DayanaHV/Fundamentos-de-Dise-o/README.md

# Fundamentos-de-Dise-o
 Ciclo 2023-0

Integrantes:
- CHAVEZ ESPIRITU, JENNIFER ARACELY
- HERRERA VALENCIA, DAYANA ARABELA
- NAVARRO VALDIVIEZO, VICTORIA JUSTA
- PACSI INGA, SARANSH DANIELA MILAGROS
- VALLE ROMERO, BRITNEY INES
