DayanaHV/Fundamentos-de-Dise-o/Hardware/Proyectos preliminares_Gran escala/Proyecto preliminar 1.pdf

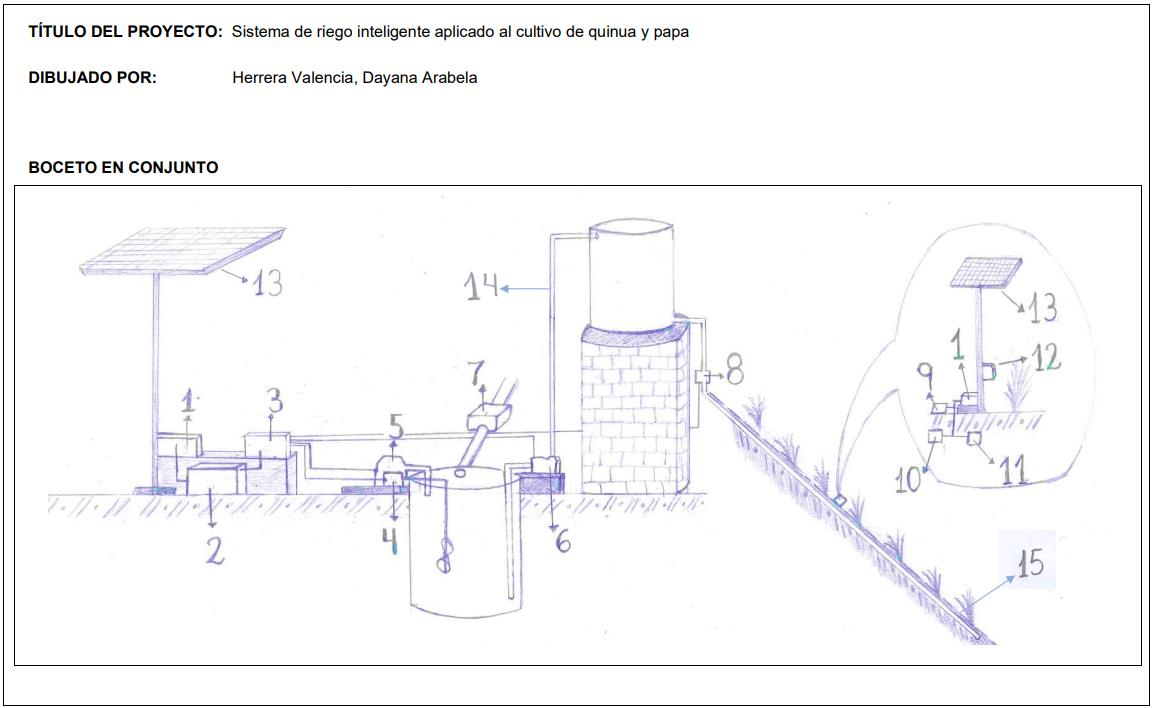
[picture p1: page 1]
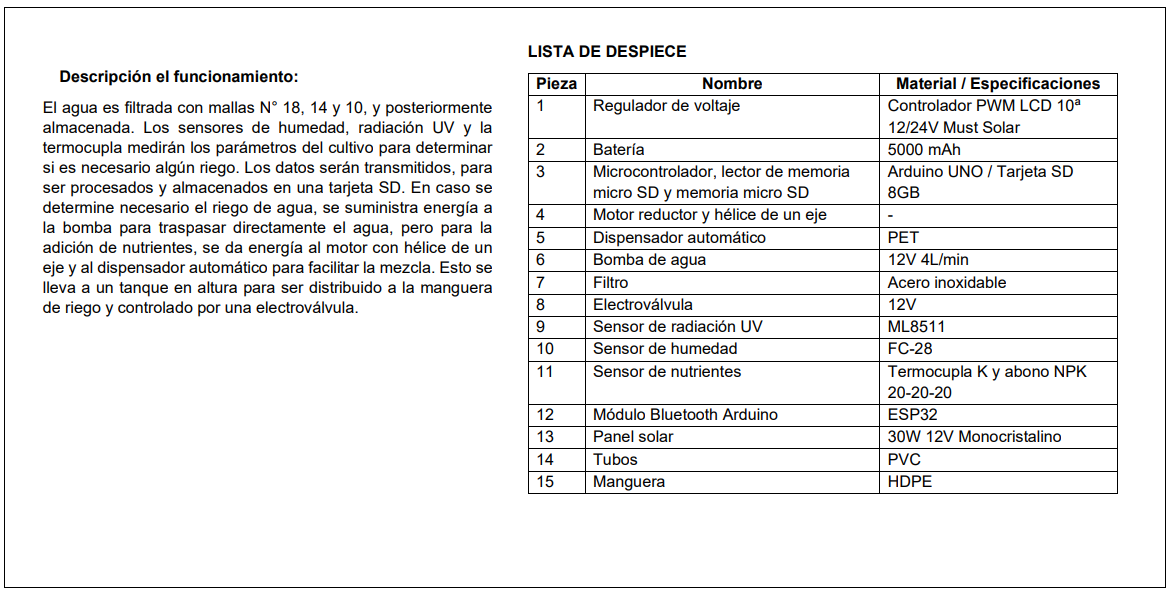
[picture p2: page 2]
