DayanaHV/Fundamentos-de-Dise-o/Hardware/Proyectos preliminares_Gran escala/Proyecto preliminar 2.pdf

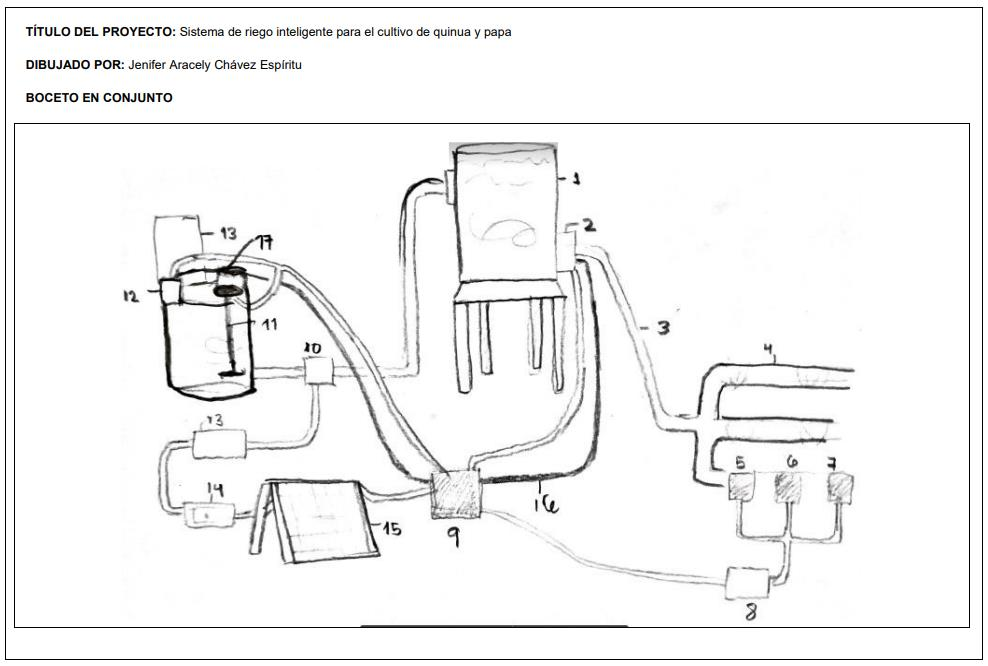
[picture p3: page 1]
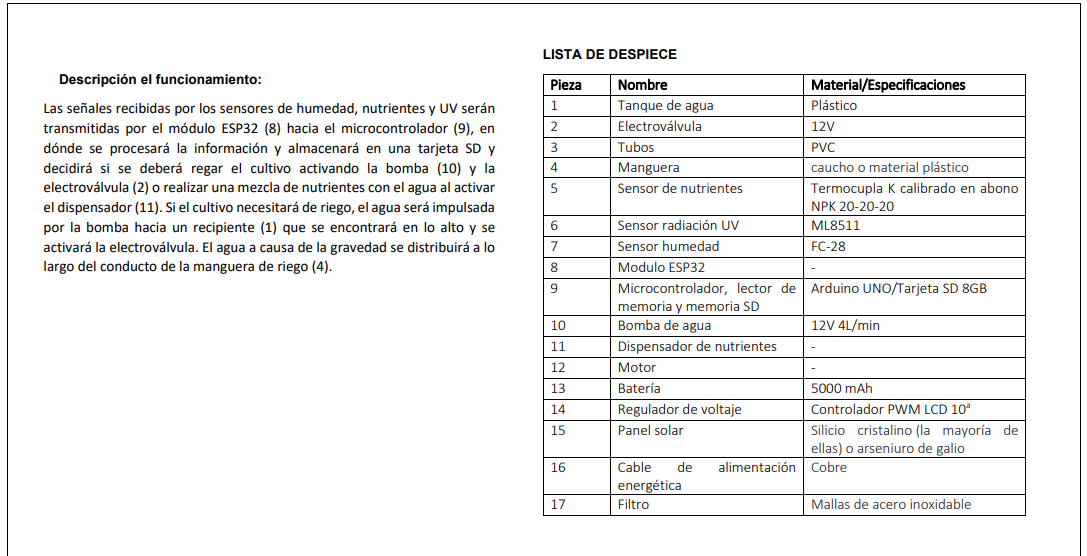
[picture p4: page 2]
