DayanaHV/Fundamentos-de-Dise-o/Hardware/Proyectos preliminares_Gran escala/Proyecto preliminar 3.pdf

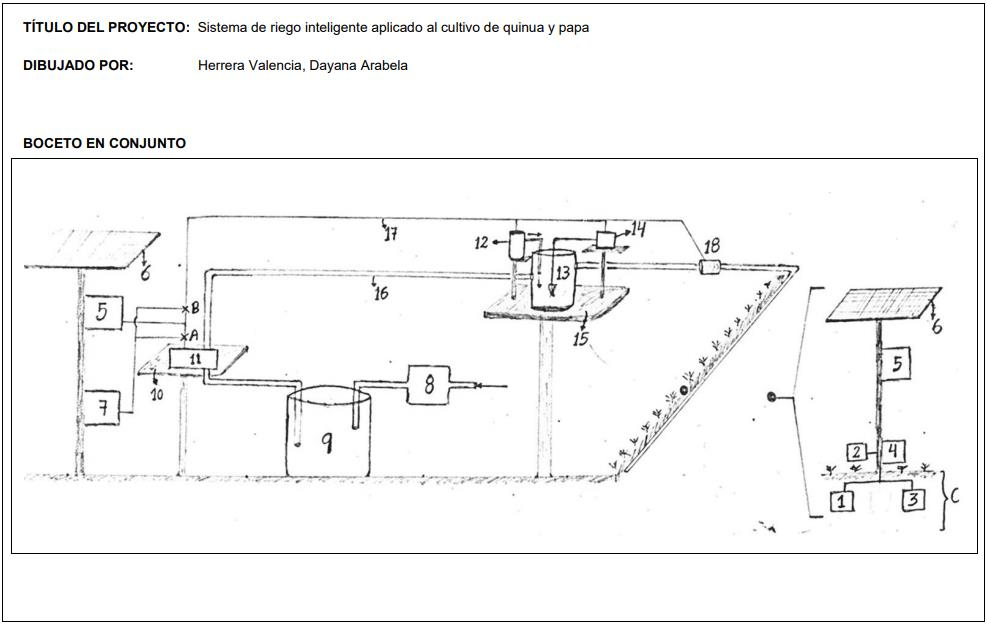
[picture p5: page 1]
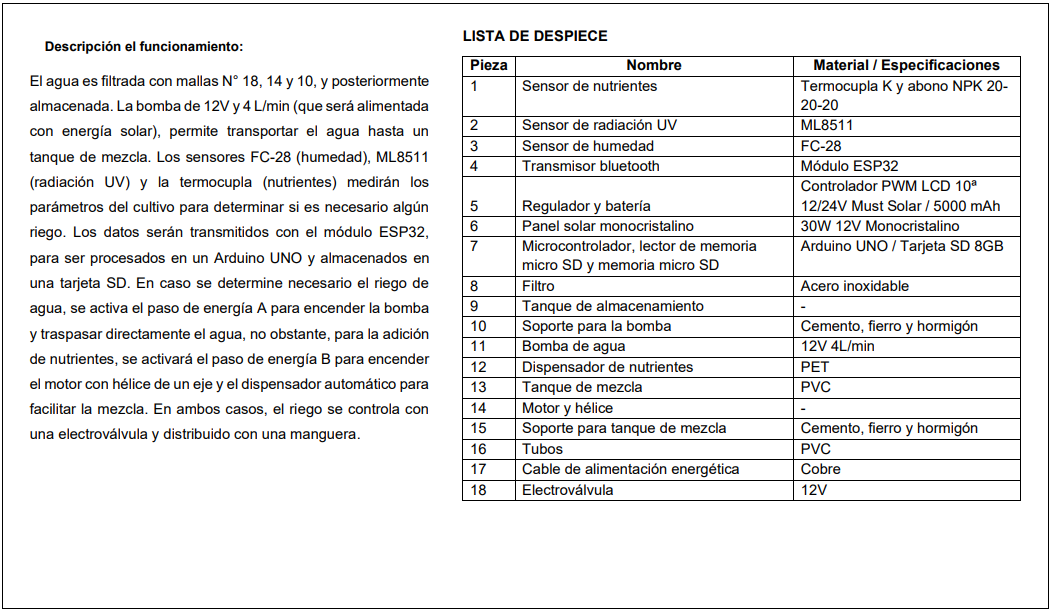
[picture p6: page 2]
