DayanaHV/Fundamentos-de-Dise-o/Hardware/Proyectos Preliminares/Gráfica de proyecto óptimo.pdf

GRÁFICA DE PROYECTO ÓPTIMO

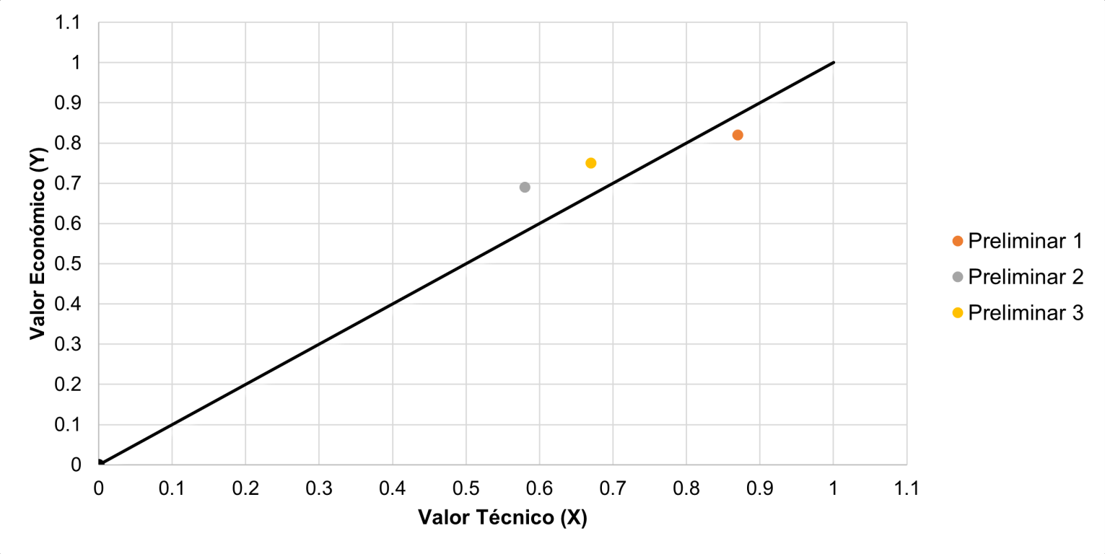
[picture p7: figure]
