DayanaHV/Fundamentos-de-Dise-o/Software/Código para la aplicación.pdf

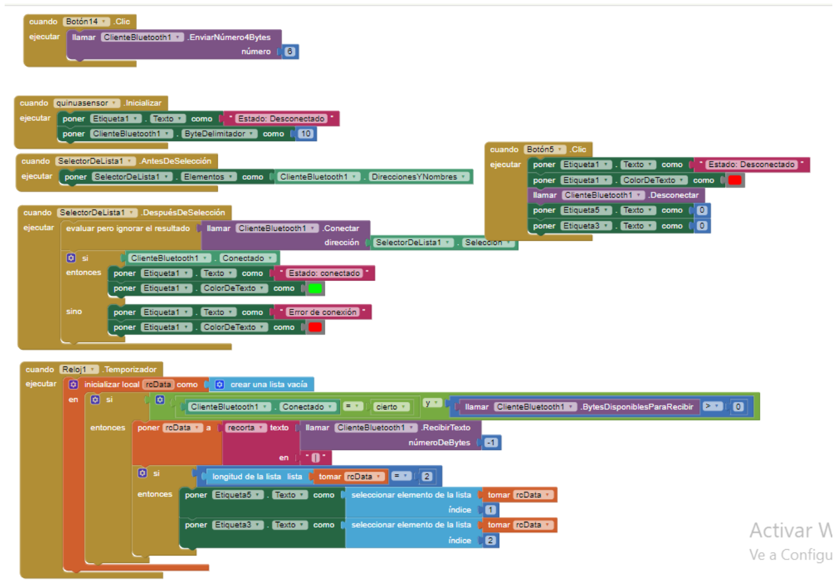
[picture p8: page 1]
