DayanaHV/Fundamentos-de-Dise-o/Hardware/Modelado 3D/Hélice.stl

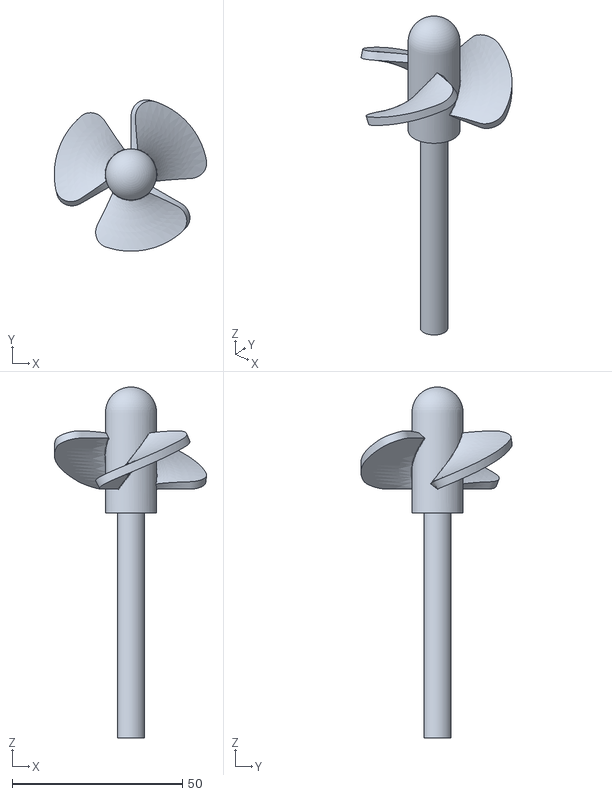
[picture p11: CAD file, 2023-02-11]
Hardware/Modelado 3D/Hélice.stl
44.7 x 44.4 x 103.0
