DayanaHV/Fundamentos-de-Dise-o/Hardware/Modelado 3D/Soporte para la hélice.stl

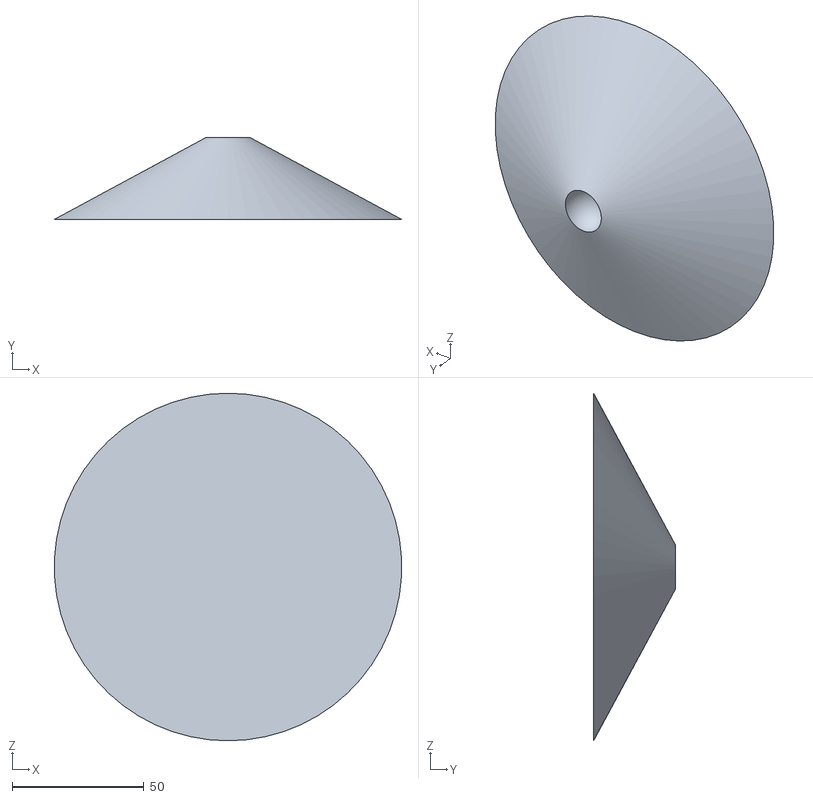
[picture p12: CAD file, 2023-02-11]
Hardware/Modelado 3D/Soporte para la hélice.stl
131.8 x 31.0 x 132.0
