DayanaHV/Fundamentos-de-Dise-o/Software/Diagrama electrónico.pdf

A

A

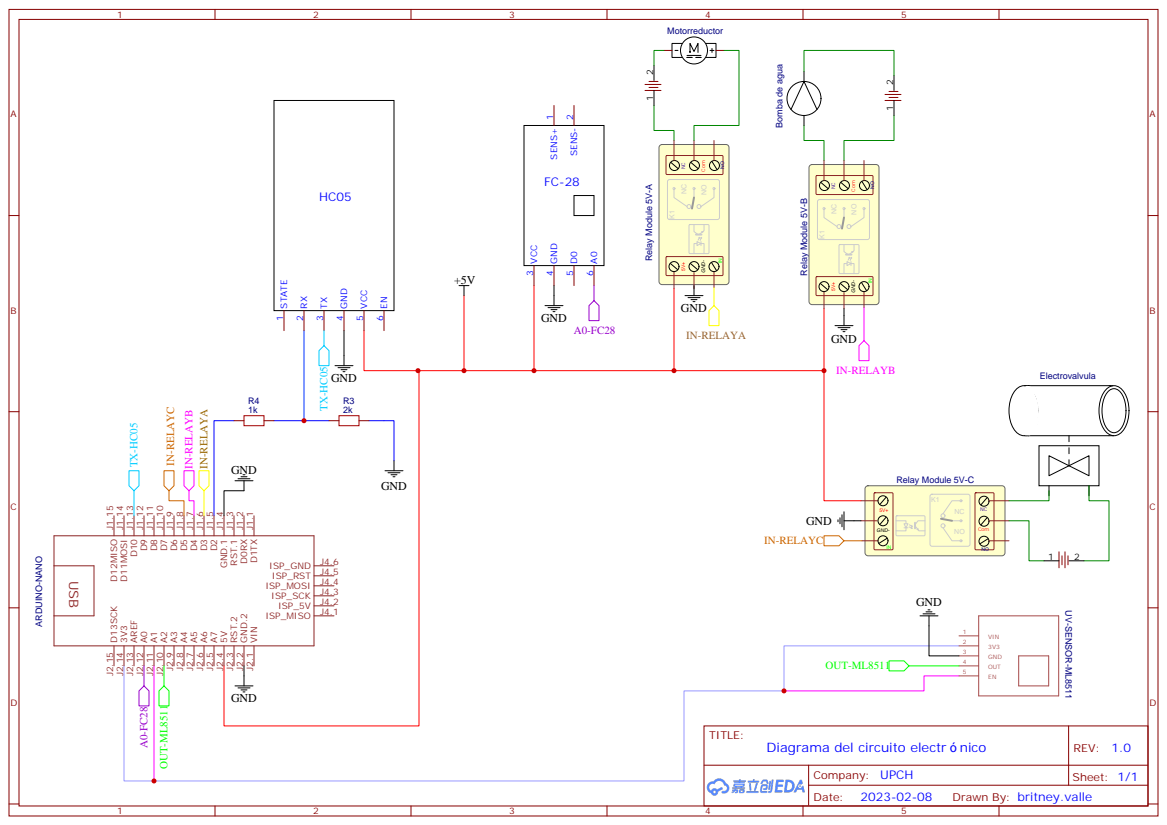
[picture p14: page 1]

D1TX J1.1 D0RX J1.2 RST.1 J1.3 GND.1 J1.4 D2 J1.5 D3 J1.6 D4 J1.7 D5 J1.8 D6 J1.9 D7 J1.10 D8 J1.11 D9 J1.12 D10 J1.13 D11MOSI J1.14 D12MISO J1.15 VIN J2.1 GND.2 J2.2 RST.2 J2.3 5V J2.4 A7 J2.5 A6 J2.6 A5 J2.7 A4 J2.8 A3 J2.9 A2 J2.10 A1 J2.11 A0 J2.12 AREF J2.13 3V3 J2.14 D13SCK J2.15

Drawn By: britney.valle
