DayanaHV/Fundamentos-de-Dise-o/Software/Diagrama de flujo del funcionamiento del sistema de riego inteligente.pdf

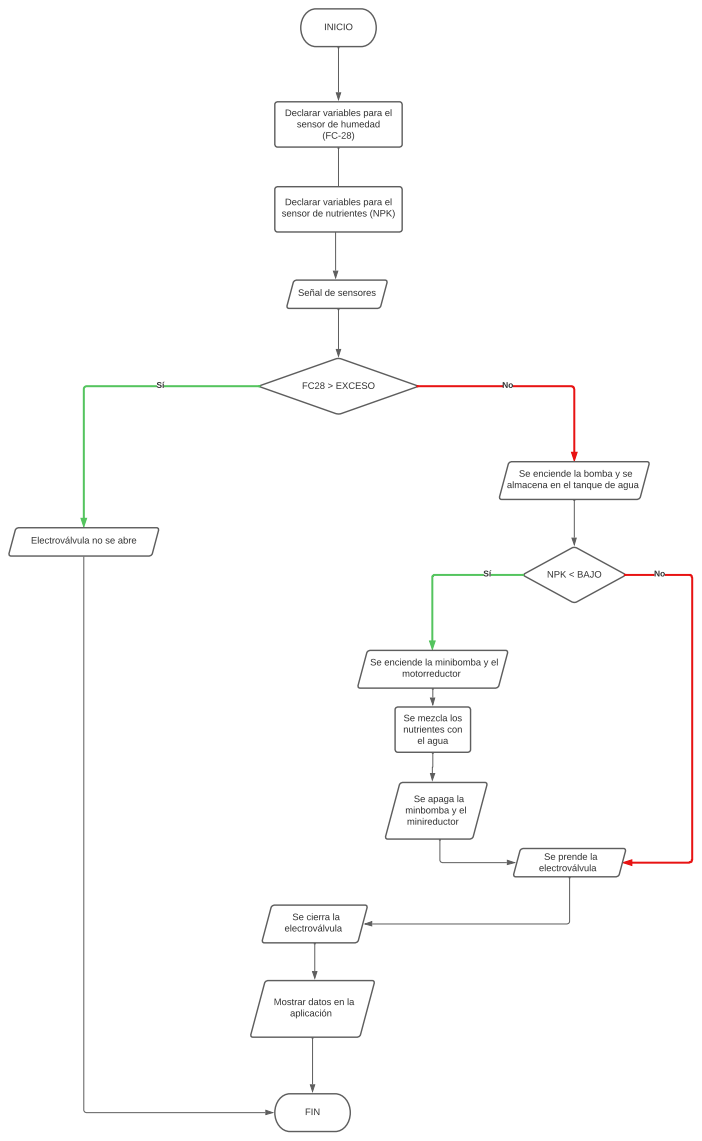
[picture p15: page 1]
INICIO; FC28 > EXCESO; NPK < BAJO; FIN

Declarar variables para el
sensor de humedad

sensor de nutrientes (NPK)

Señal de sensores

Se enciende la bomba y se
almacena en el tanque de agua

Electroválvula no se abre

Se enciende la minibomba y el
motorreductor

Se mezcla los
nutrientes con
el agua

Se apaga la
minbomba y el
minireductor

Se prende la
electroválvula

Se cierra la

Mostrar datos en la
aplicación
