DayanaHV/Fundamentos-de-Dise-o/Software/Diagrama de flujo del sensor FC-28.pdf

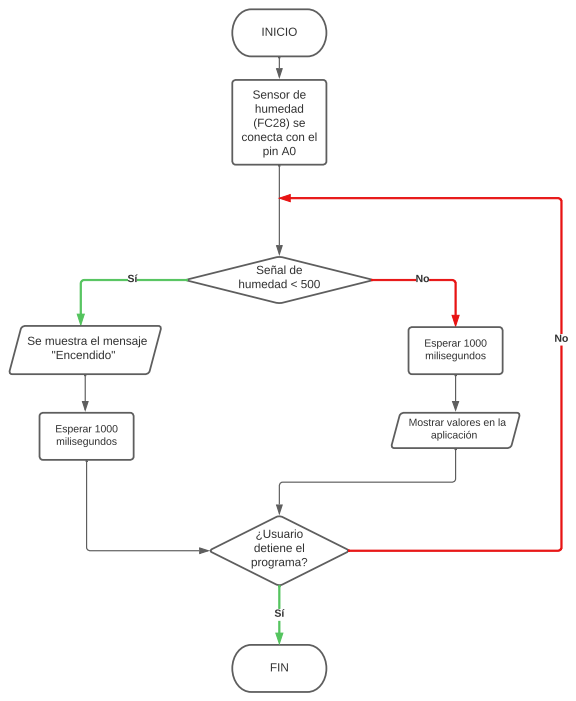
[picture p16: page 1]
INICIO; Señal de humedad < 500 Sí; Esperar 1000 milisegundos; FIN; ¿Usuario detiene el programa?

Sensor de
humedad
conecta con el
pin A0

Se muestra el mensaje
"Encendido"

Mostrar valores en la
aplicación
