DayanaHV/Fundamentos-de-Dise-o/Software/Diagrama de flujo de la aplicación.pdf

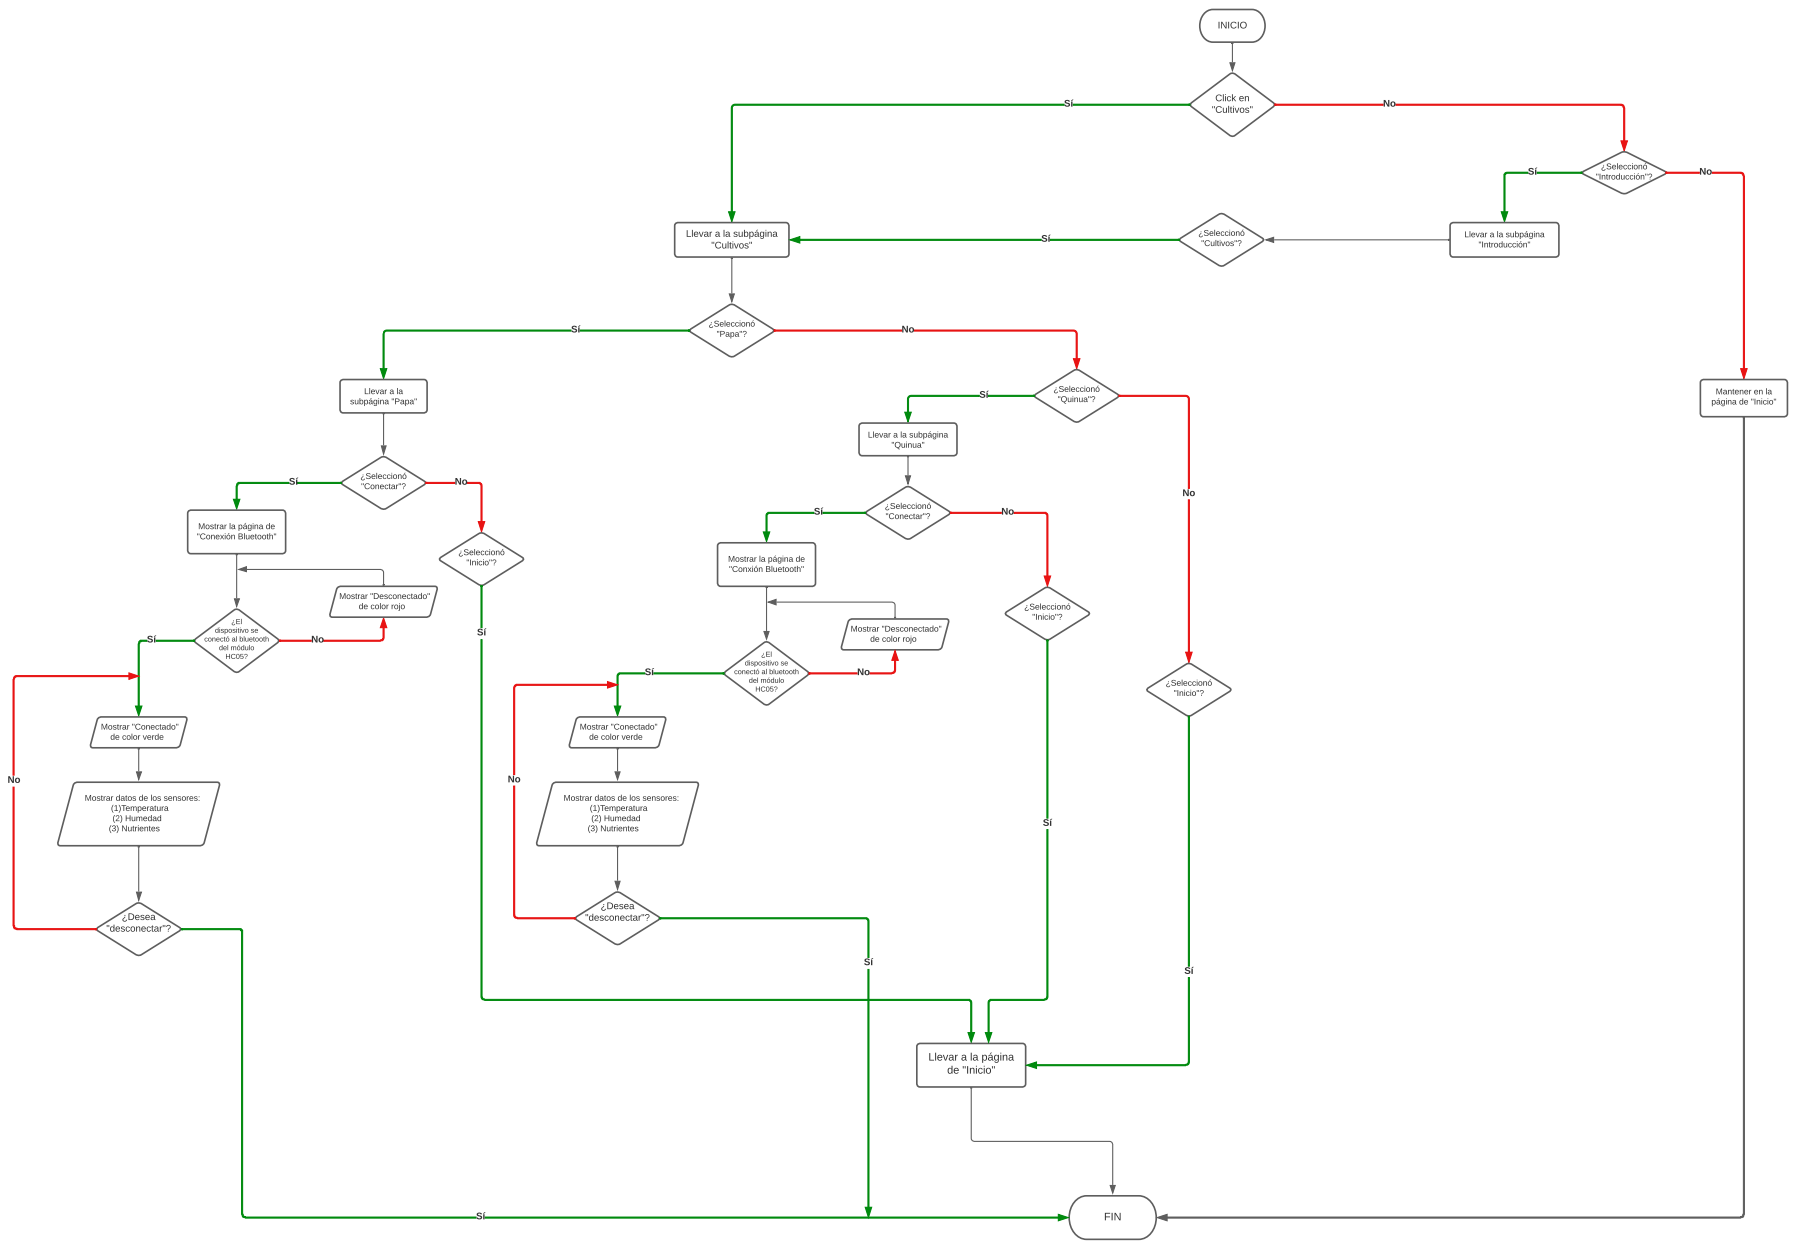
[picture p17: page 1]
Click en "Cultivos"; INICIO; ¿Seleccionó "Introducción"?; ¿Seleccionó "Papa"? Sí; Llevar a la subpágina "Papa"; ¿Seleccionó "Quinua"? Sí; ¿Seleccionó "Inicio"?; ¿Seleccionó "Cultivos"? Sí; ¿Seleccionó; "Conectar"? Sí; FIN; ¿Desea "desconectar"?

Llevar a la subpágina
"Cultivos"

"Introducción"

Mantener en la
página de "Inicio"

"Quinua"

Mostrar la página de
"Conexión Bluetooth"

"Conxión Bluetooth"

Mostrar "Desconectado"
de color rojo

dispositivo se
conectó al bluetooth
del módulo HC05?

Mostrar "Conectado"
de color verde

Mostrar datos de los sensores:
(1)Temperatura
(2) Humedad
(3) Nutrientes

Llevar a la página
de "Inicio"
