DayanaHV/Fundamentos-de-Dise-o/Hardware/Planos/Plano general.pdf

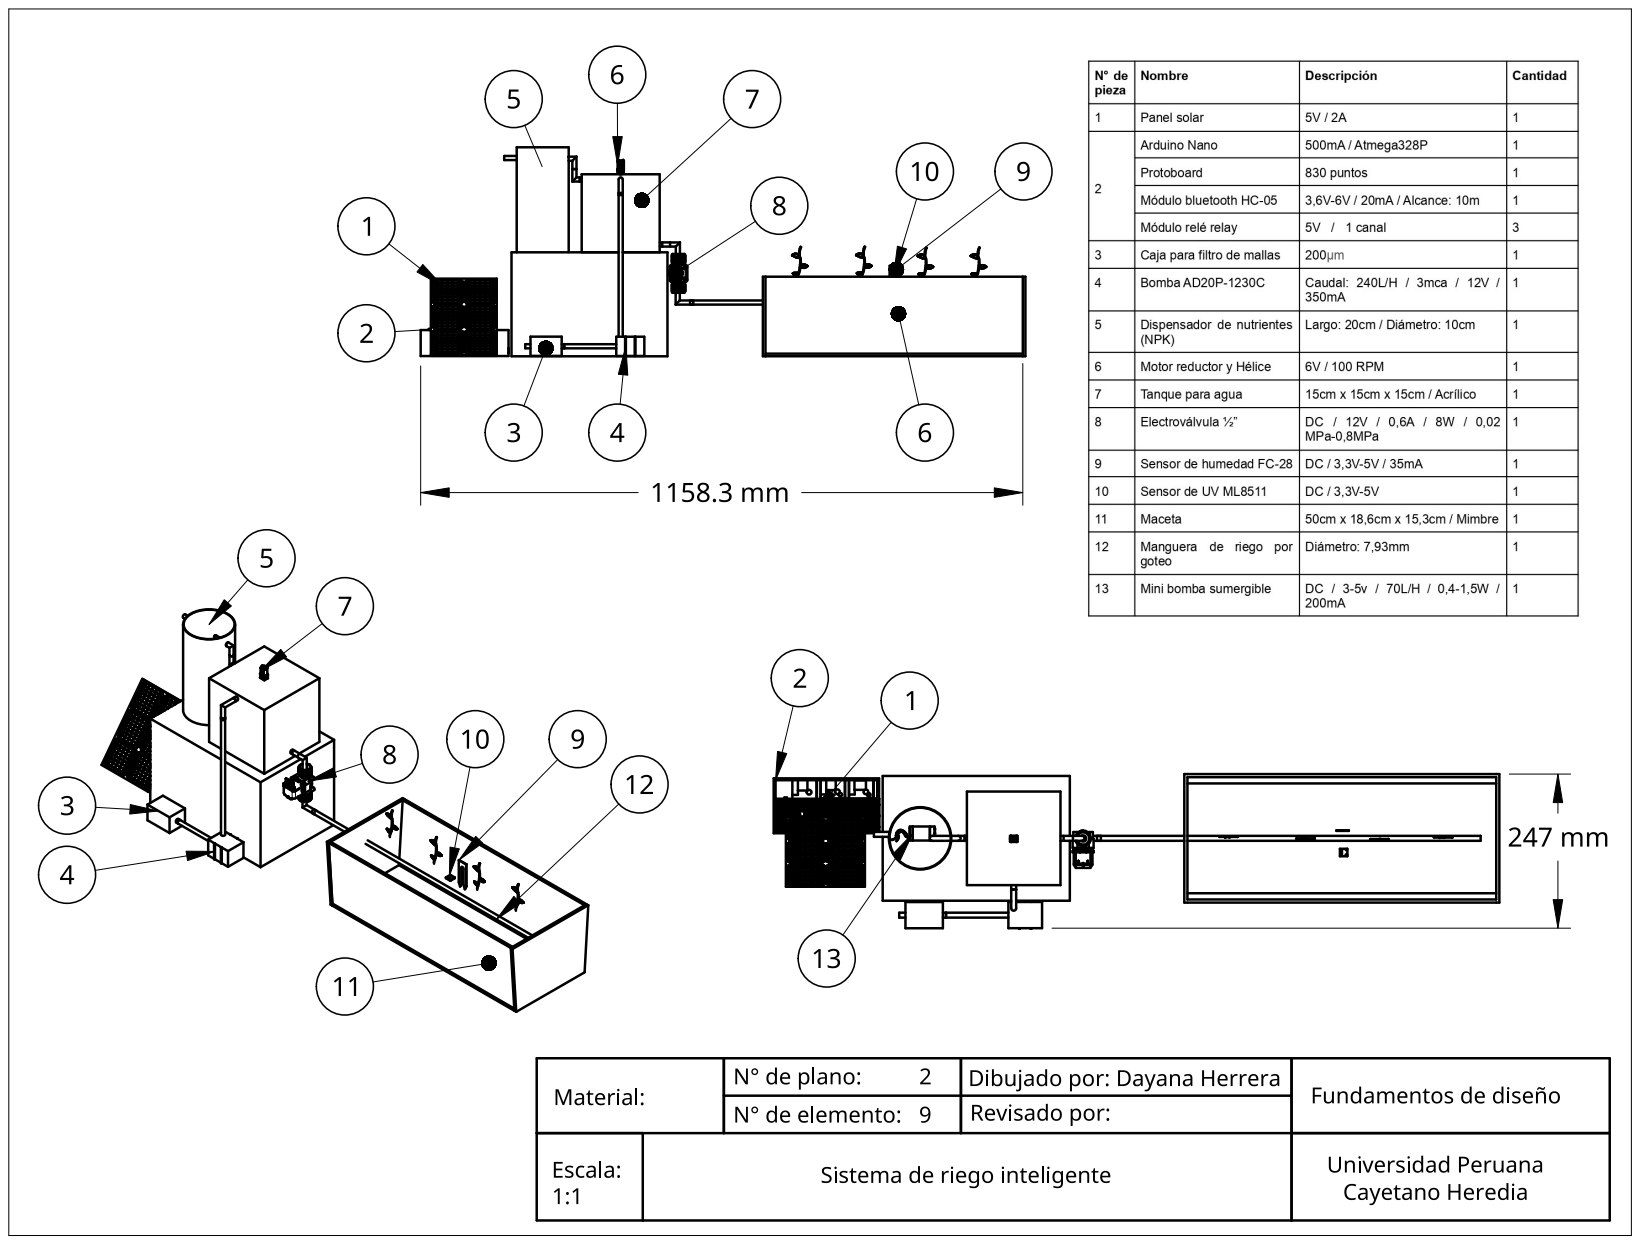
[picture p18: page 1]
