DayanaHV/Fundamentos-de-Dise-o/Hardware/Planos/Plano de caja de componentes electrónicos.pdf

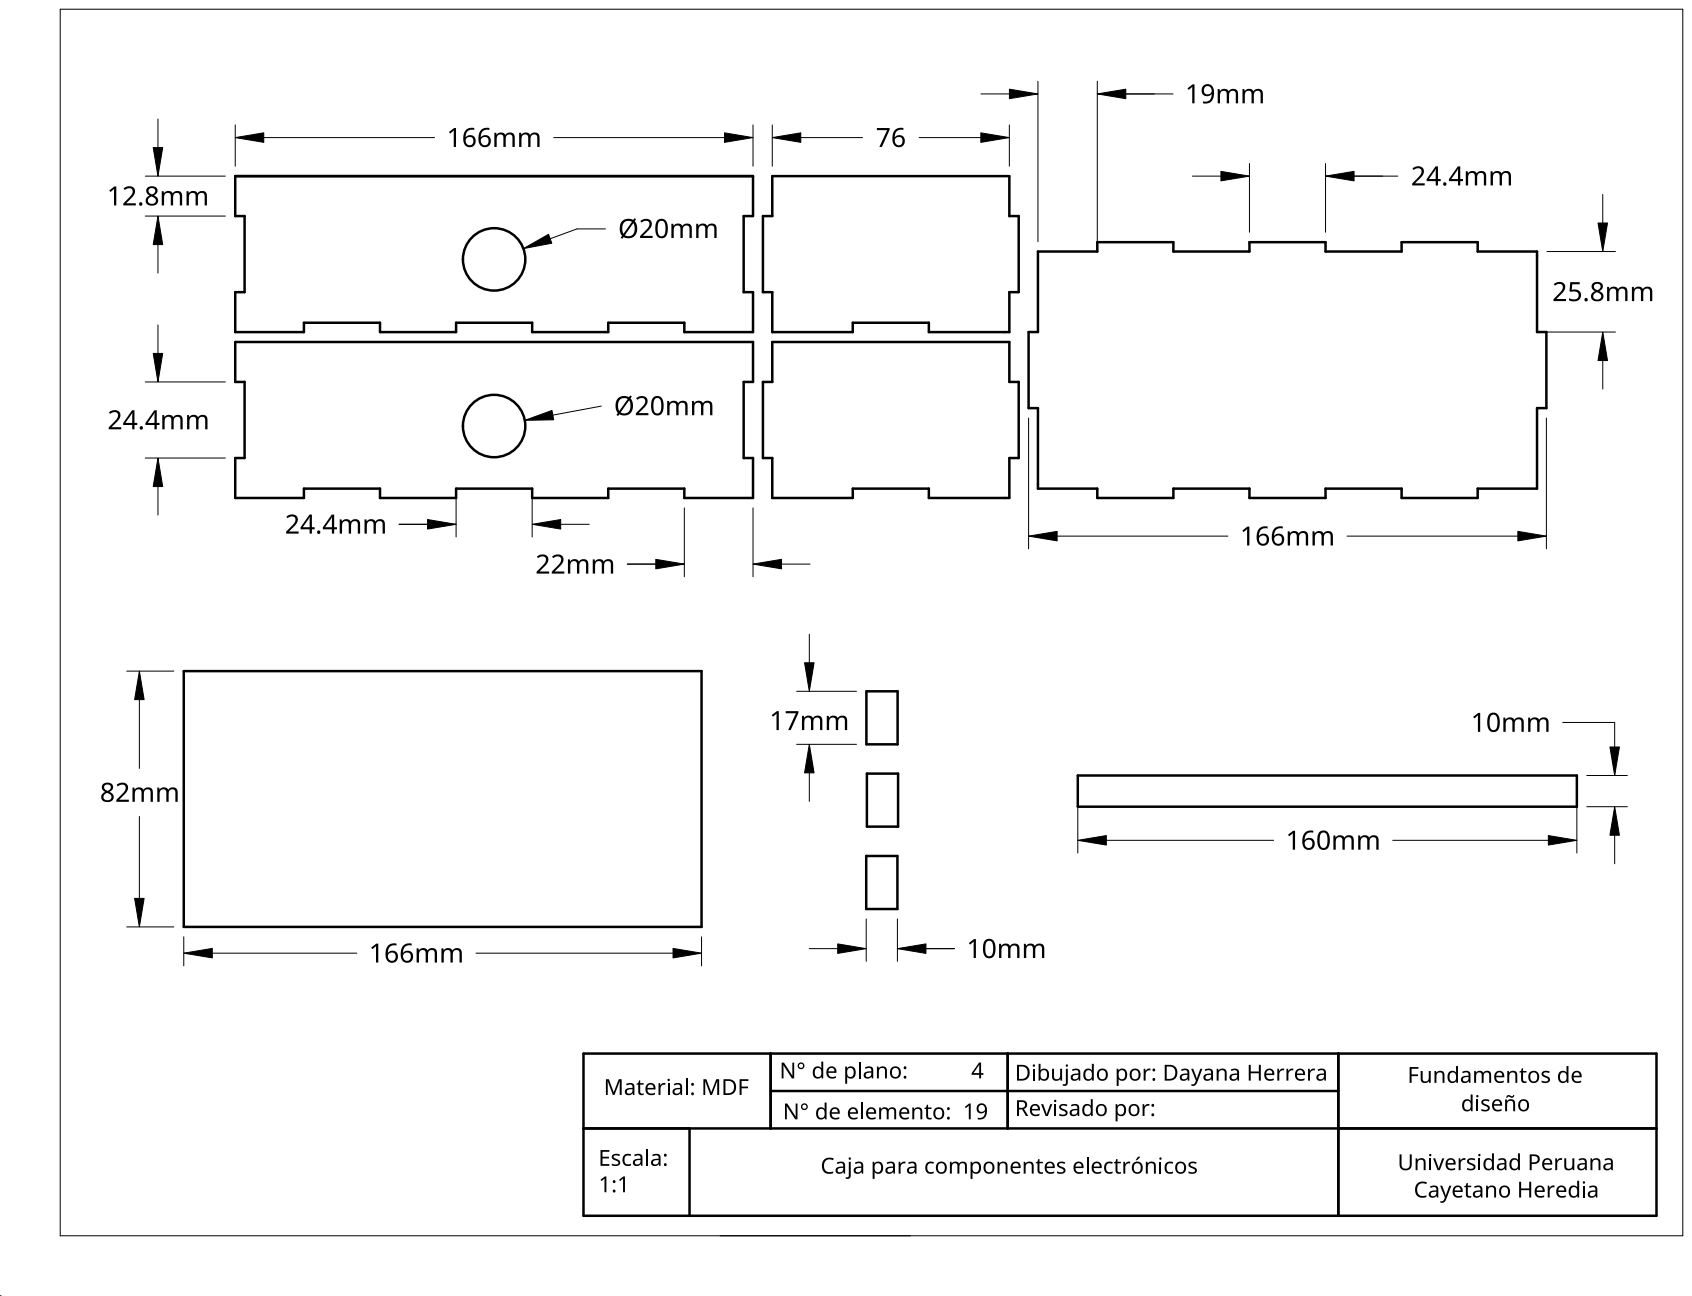
[picture p19: page 1]
