DayanaHV/Fundamentos-de-Dise-o/Hardware/Planos/Plano de hélice.pdf

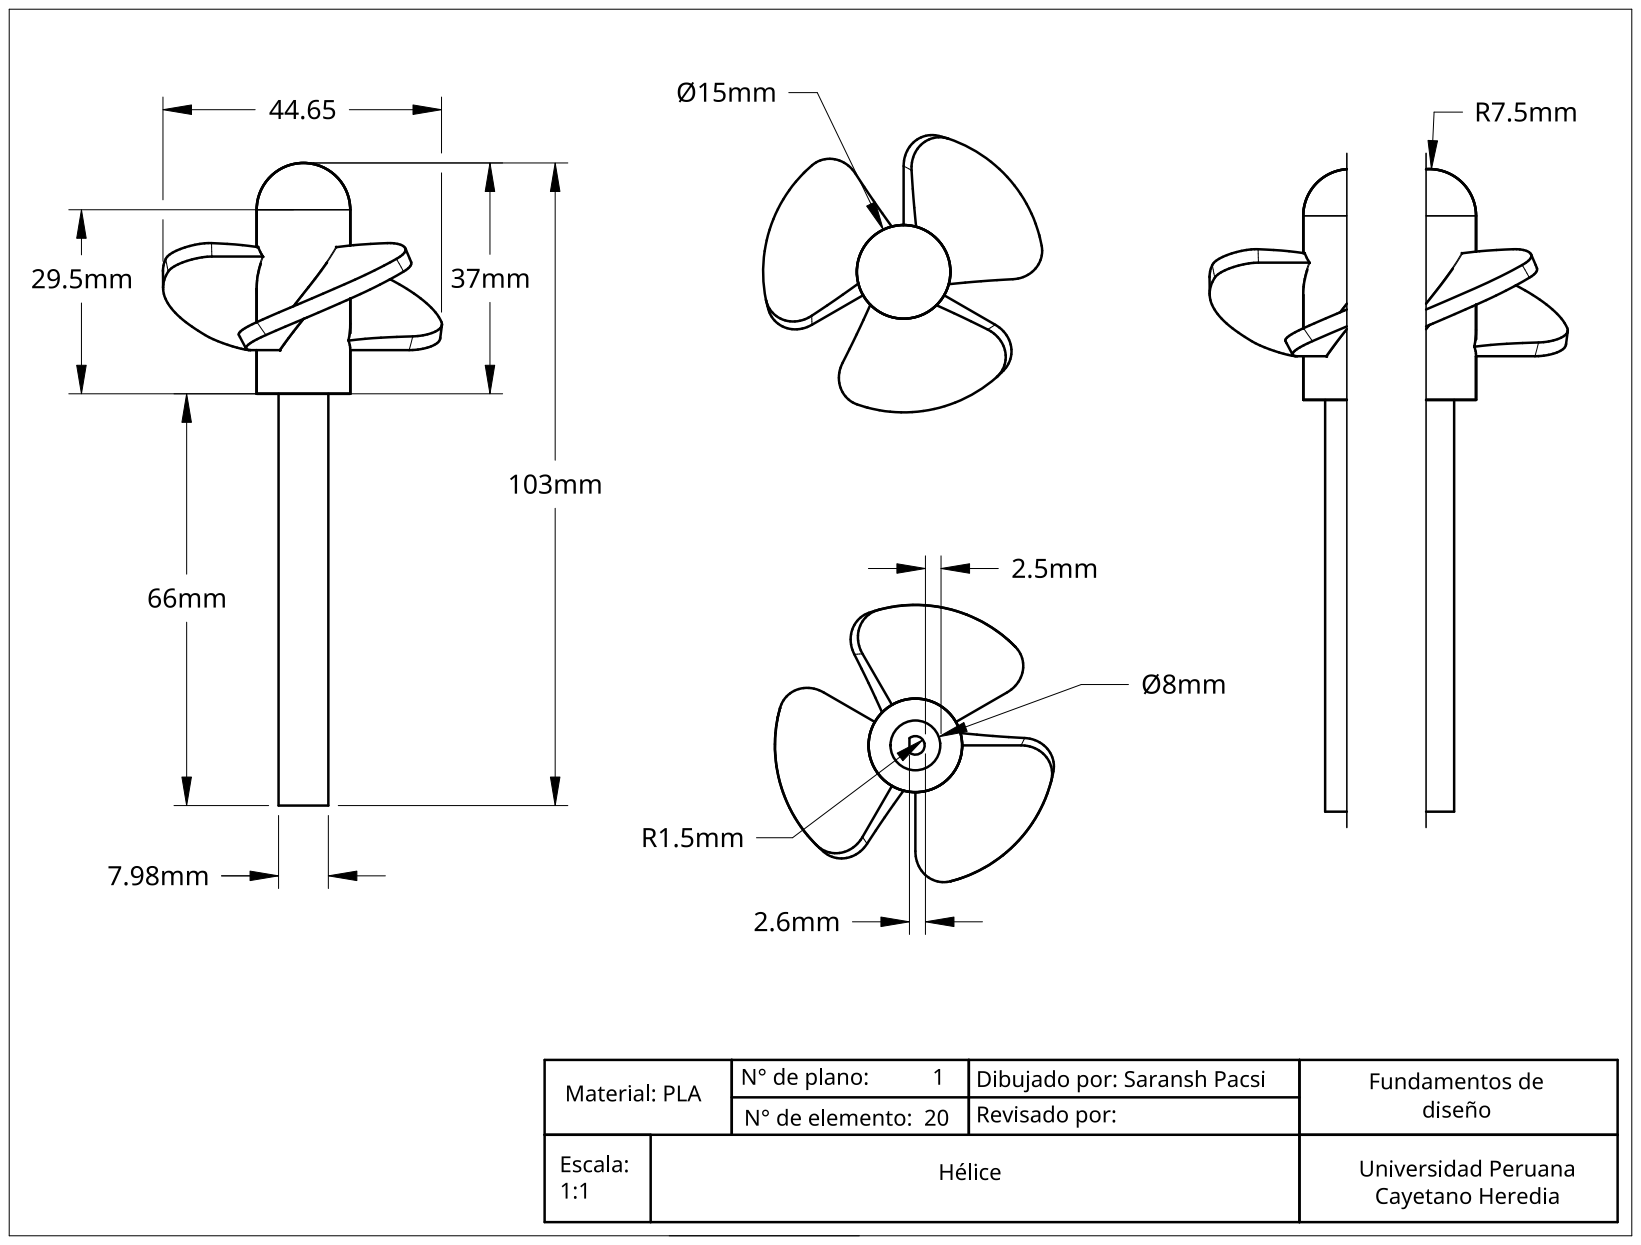
[picture p20: page 1]
