DayanaHV/Fundamentos-de-Dise-o/Hardware/Planos/Plano de soporte para el tanque y el diapensador de nutrientes.pdf

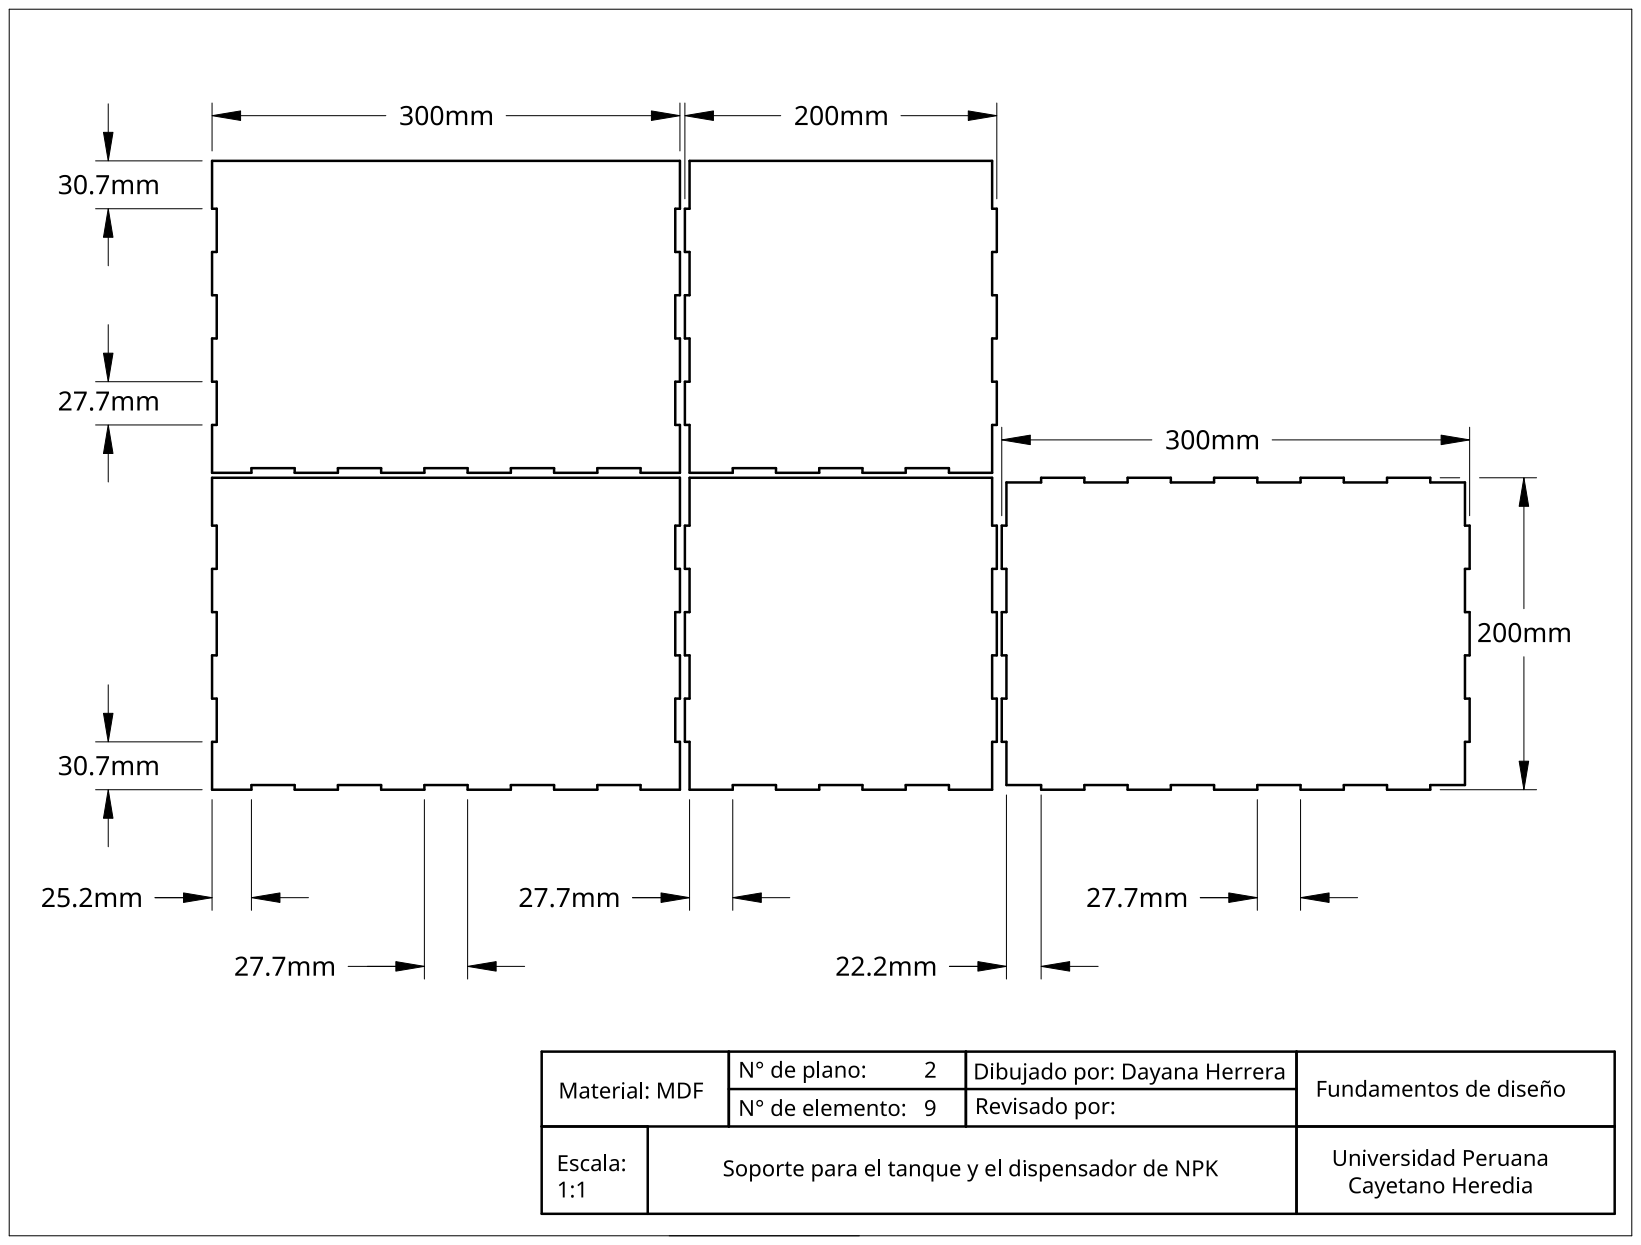
[picture p21: page 1]
