DayanaHV/Fundamentos-de-Dise-o/Hardware/Planos/Plano de soporte para hélice.pdf

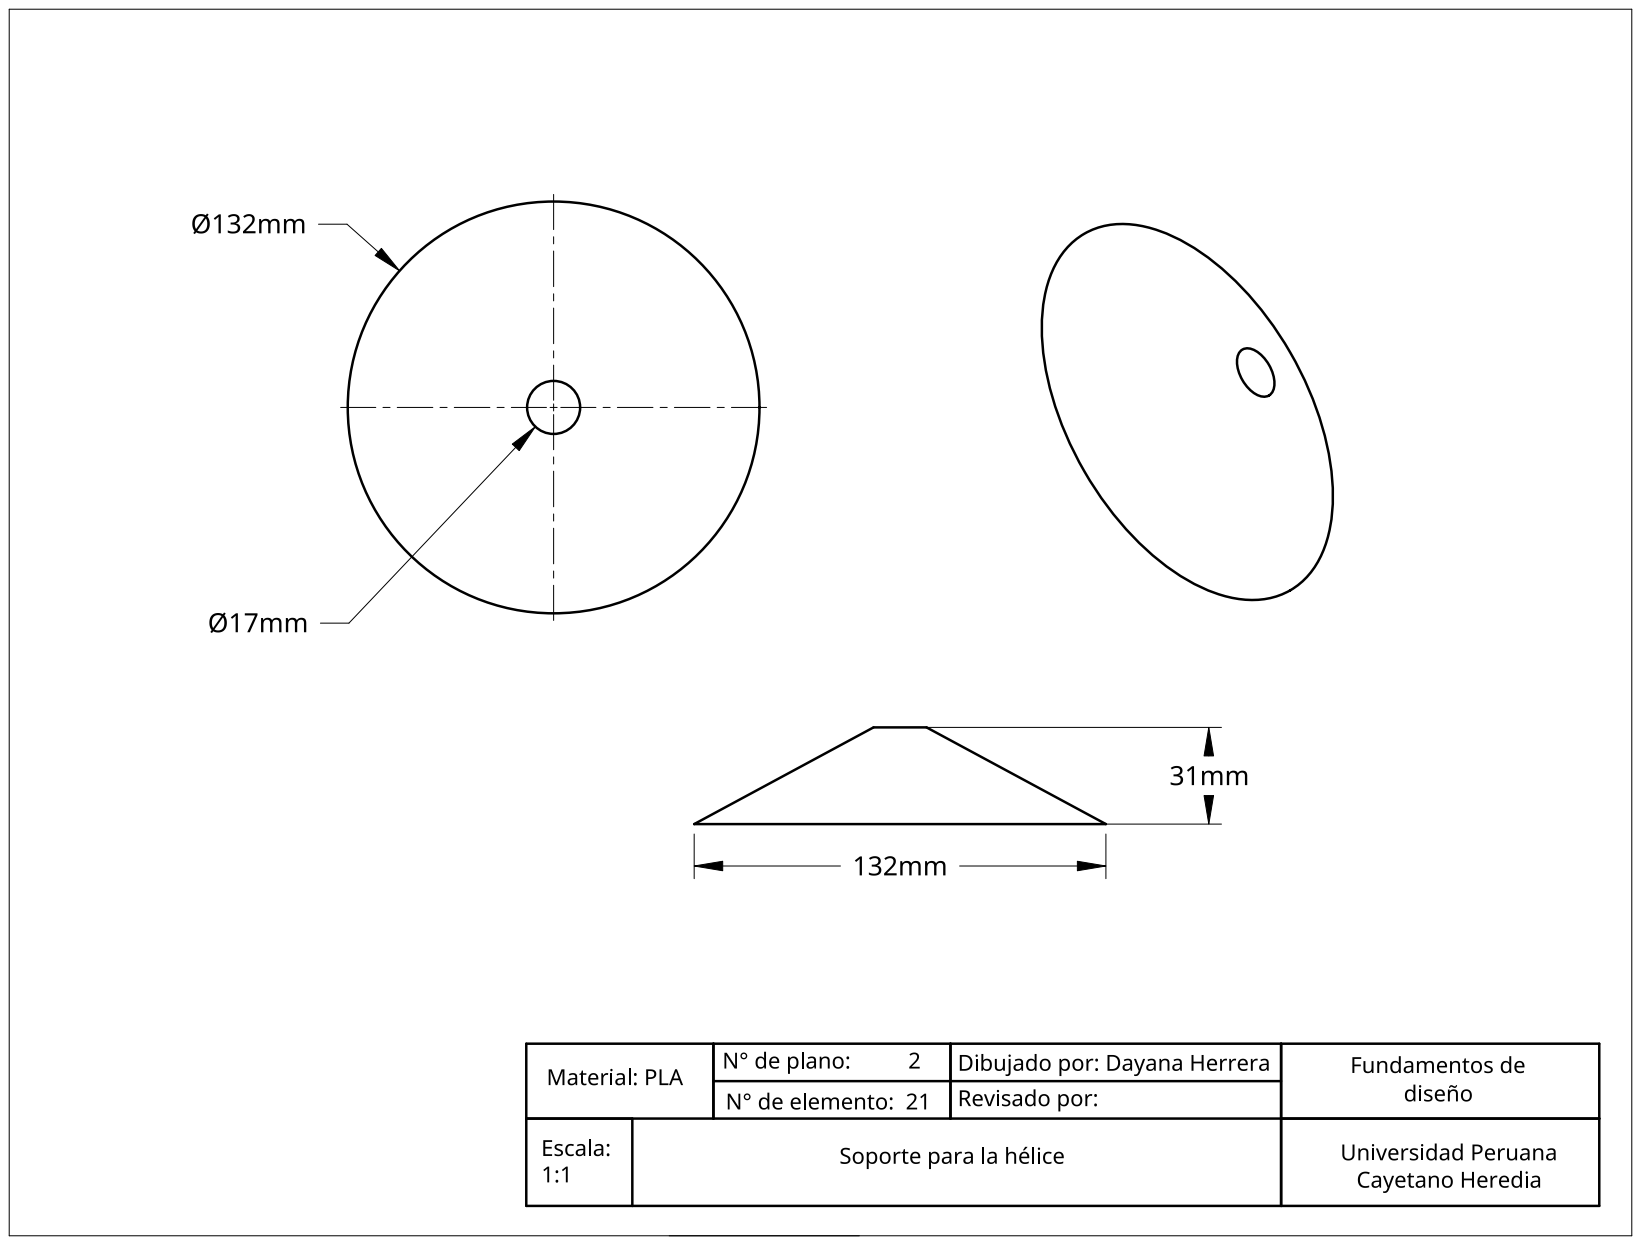
[picture p22: page 1]
