DayanaHV/Fundamentos-de-Dise-o/Hardware/Planos/Plano de tanque para agua.pdf

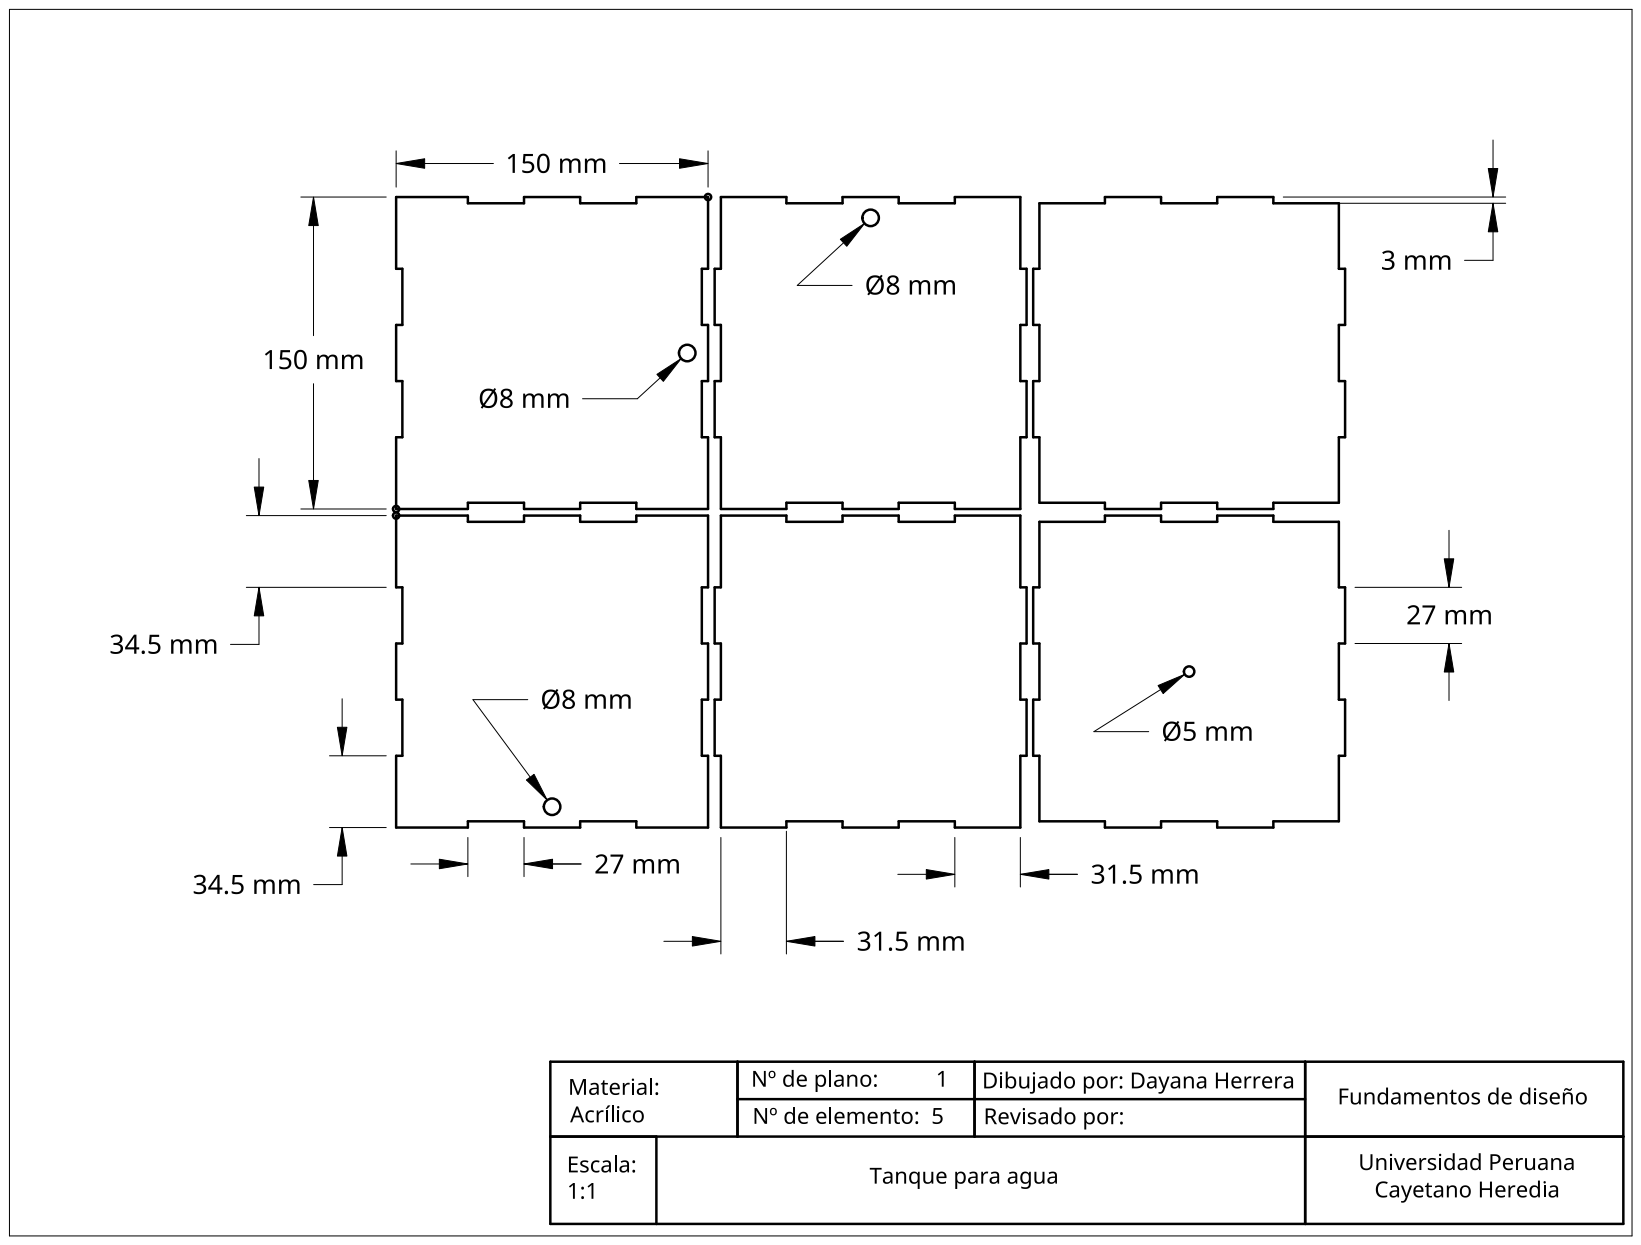
[picture p23: page 1]
