DayanaHV/Fundamentos-de-Dise-o/Hardware/Planos/Plano de caja para filtro de agua.pdf

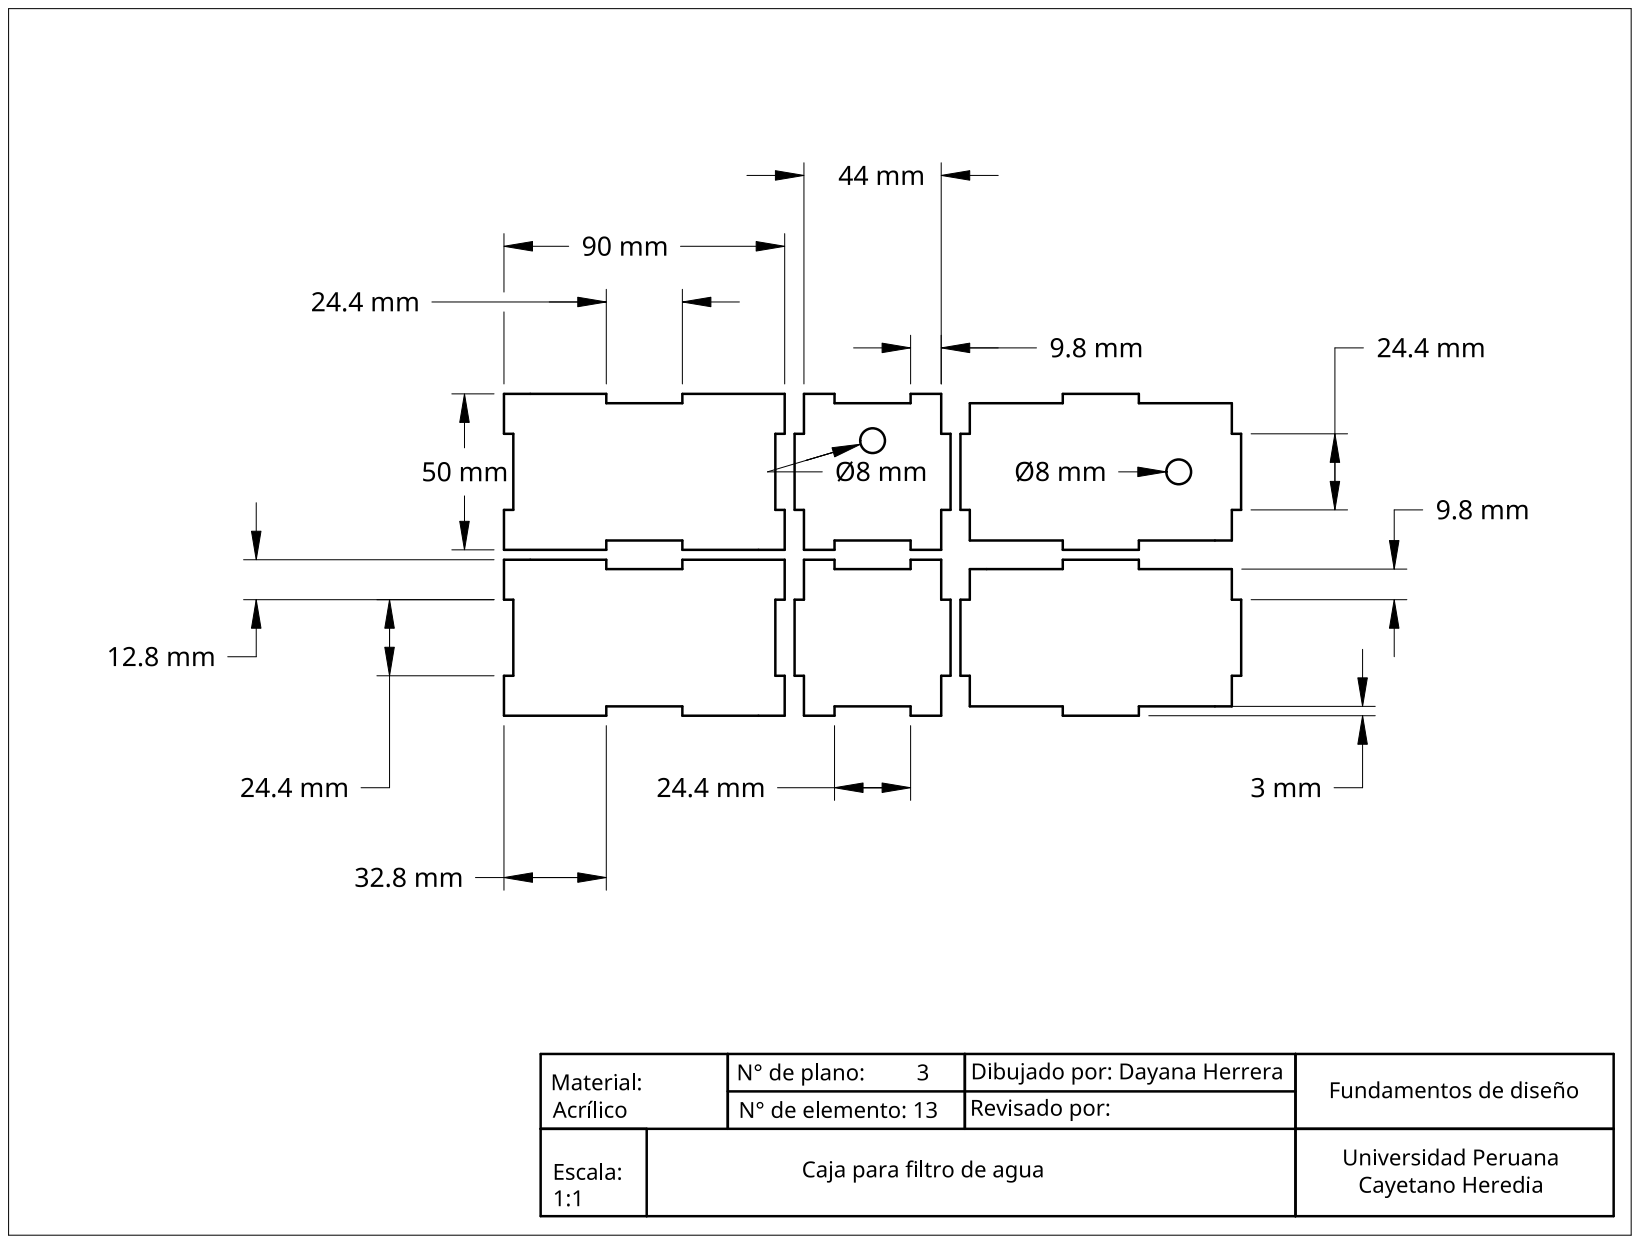
[picture p24: page 1]
