DayanaHV/Fundamentos-de-Dise-o/(commit log)

2023-02-05 Create Matriz de evaluación técnica y económica
2023-02-15 Create Plano de hélice
